twistedpickups/integrator/IntEnclosure_5_95_inside.png

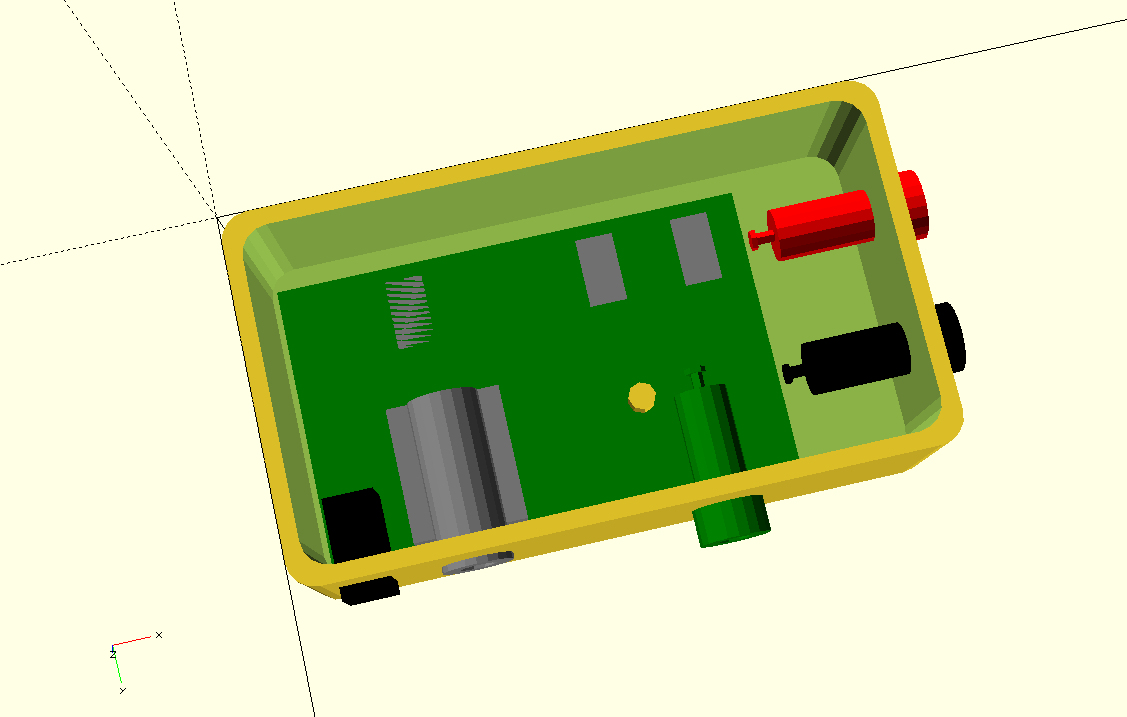
IntEnclosure_5_95_inside.png
