twistedpickups/integrator/IntEnclosure_5_95_topview.png

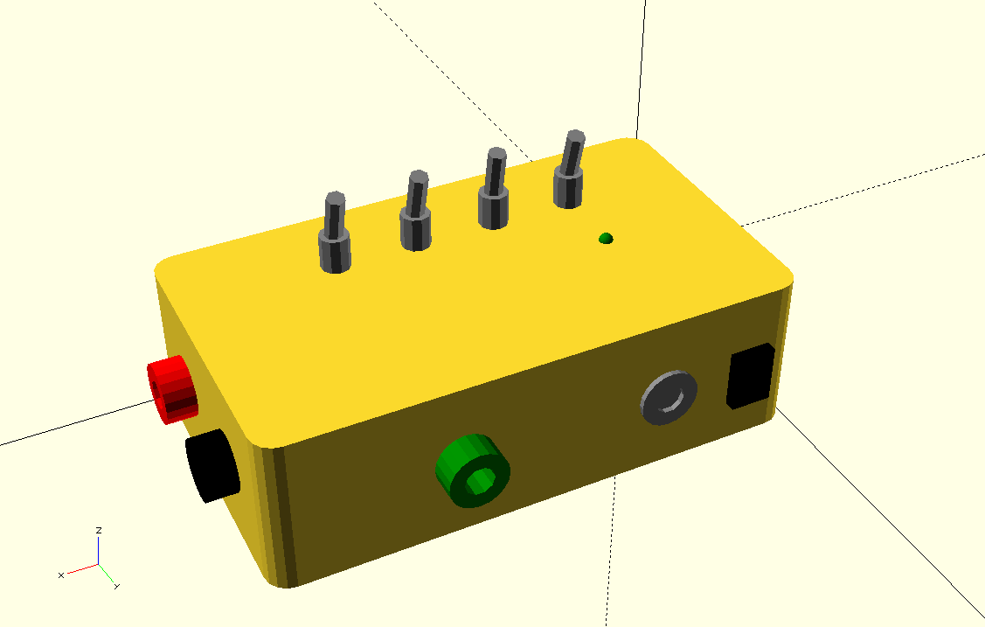
IntEnclosure_5_95_topview.png
