twistedpickups/integrator/V5.95-BOM.ods

Sheet: PCB
Designation | Value | Description | Part # | Manufacturer | Supplier | Supplier Part # | SMD Part | Cost $US | Cost per Unit (CAN$) | Notes
IC1 |  | JFET op amp | LT1058ACN | Linear Technology | Mouser | 584-LT1058CN#PBF | 584-LT1058SW#PBF | 10.27 | $11.91 | Substitutes: LT1058CN/OP482/LF347B/TL084
D1 | 6.2V/500mW | Zener diode | 1N753A | Central Semiconductor | Mouser | 610-1N753A | 771-BZV55-C6V2-T/R | 0.19 | $0.59
D2 |  | Reverse Protection Diode |  |  |  |  | 863-MBRS260T3G
LED1 | Green | LED | LTL-4231N | Lite-On | Mouser | 859-LTL-4231N |  |  | $0.10 | 3mm
S1 | On-off-on | toggle switch | 100SP3T1B1M2QEH | E-switch | Mouser | 612-100-C1121 |  |  | $4.06
S2 | On-on | toggle switch | 100SP1T1B1M2QEH | E-switch | Mouser | 612-100-A1121 |  |  | $3.37
S3 | On-on | toggle switch | 100SP1T1B1M2QEH | E-switch | Mouser | 612-100-A1121 |  |  | $3.37
S4 | DPDT | toggle switch |  | E-switch | Mouser |  | 612-100-F1121 |  | $3.37
R2 | 1.0M | 1/4W resistor 5% | CFR-25JR-52-1M | Yageo | Mouser | 603-CFR-25JR-52-1M | 71-RCG08051M00FKEA |  | $0.14
R6 | 1.8M | 1/4W resistor 5% | CFR-25JB-52-1M8 | Yageo | Mouser | 603-CFR-25JB-52-1M8 | 71-CRCW08051M80FKEA |  | $0.14
R8 | 1.8M | 1/4W resistor 5% | CFR-25JB-52-1M8 | Yageo | Mouser | 603-CFR-25JB-52-1M8 | 71-CRCW08051M80FKEA |  | $0.14
R9 | 10k | 1/4W resistor 5% | CFR-25JB-52-10K | Yageo | Mouser | 603-CFR-25JB-52-10K | 71-CRCW080510K0FKEAC |  | $0.14
R10 | 10k | 1/4W resistor 5% | CFR-25JB-52-10K | Yageo | Mouser | 603-CFR-25JR-52-10K | 71-CRCW080510K0FKEAC |  | $0.14
R1 | 9.1M | 1/4W resistor 5% | CFR-25JB-52-9M1 | Yageo | Mouser | 603-CFR-25JB-52-9M1 | 71-CRCW0805-9.1M-E3 |  | $0.14
R4 | 180k | 1/4W resistor 5% | CFR-25JB-52-180K | Yageo | Mouser | 603-CFR-25JB-52-180K | 652-CR0805FX-1803ELF |  | $0.14
R5 | 18k | 1/4W resistor 5% | CFS1/4CT52R183J | Koa Speer | Mouser | 660-CFS1/4CT52R183J | 660-RK73H2ATTD1802F |  | $0.24
R11 | 200k | 1/4W resistor 5% | CFR-25JB-52-200K | Yageo | Mouser | 603-CFR-25JB-52-200K | 660-RK73H2ATTD2003F |  | $0.14
R3 | 20k | 1/4W resistor 5% | CFR-25JB-52-20K | Yageo | Mouser | 603-CFR-25JB-52-20K | 652-CR0805FX-2002ELF |  | $0.14
R7 | 39k | 1/4W resistor 5% | CFR-25JR-52-39K | Yageo | Mouser | 603-CFR-25JR-52-39K | 660-RK73H2ATTDD3902F |  | $0.14
C4 | 0.1u | MLCC capacitor | SR215C104JARTR1 | AVX | Mouser | 581-SR215C104JARTR1 | 667-ECP-U1C104MA5 |  | $0.47 | 50V 5% | 16v,20% film
C8 | 0.1u | MLCC capacitor | SR215C104JARTR1 | AVX | Mouser | 581-SR215C104JARTR1 | 963-UMF212B7104KGHT |  | $0.47 | 50V 5% | 50V, 10% mlcc
C9 | 0.1u | MLCC capacitor | SR215C104JARTR1 | AVX | Mouser | 581-SR215C104JARTR1 | 963-UMF212B7104KGHT |  | $0.47 | 50V 5%
C6 | 10n | MLCC capacitor | SR155C103JAA | AVX | Mouser | 581-SR155C103JAA | 667-ECH-U1C103GX5 |  | $0.65 | 50V 5% | 16V,2%, film
C7 | 10u | tantalum capacitor | TAP106K025SCS | AVX | Mouser | 581-TAP106K025SCS | 581-TAJA106K016RNJV |  | $1.24 | 25V 10% | 16V, 10%
C5 | 1u | MLCC capacitor | C330C105J5R5TA | Kemet | Mouser | 80-C330C105J5R | 791-0805B105J250CT |  | $2.32 | 50V 5% | 25V, 5%, mlcc
C10 | 1u | MLCC capacitor | C330C105J5R5TA | Kemet | Mouser | 80-C330C105J5R | 791-0805B105J250CT |  | $2.32 | 50V 5% | 25V, 5%, mlcc
C3 | 20p | MLCC capacitor | SR211A200JAR | AVX | Mouser | 581-SR211A200JAR | 80-C0805C200J5HACTU |  | $0.51 | 100V 5% | 50V, 5%, mlcc
C12 | 4.7n | MLCC capacitor | SR215C472JARTR1 | AVX | Mouser | 581-SR215C472JARTR1 | 667-ECH-U1C472GX5 |  | $0.47 | 50V 5% | 16V, 2%, film
C11 | 470p | MLCC capacitor | SR215A471JARTR1 | AVX | Mouser | 581-SR215A471JARTR1 | 667-ECH-U1H471GX5 |  | $0.44 | 50V 5% | 50V, 2%, film
C1 | 4p | MLCC capacitor | RDE5C1H4R0C0S1H03A | Murata | Mouser | 81-RDE5C1H4R0C0S1H3A | 791-0805N4R0C500CT |  | $0.50 | 50V | 50V, +/-0.25%
C2 | 5-20p | trimmer capacitor | GKG20015 | Sprague-Goodman | Mouser | 659-GKG20015 |  |  | $6.07 | 6mm
CN1 |  | DC Power Jack |  |  | Mouser |  | 806-KLDHCX-0202-AC-1 | 1.01
BJ1 | Red | Banana Jack |  |  | Mouser |  | 108-0902-001 | 0.65
BJ2 | Black | Banana Jack |  |  | Mouser |  | 530-108-0903-1 | 0.64
BJ3 | Gnd | Banana Jack |  |  | Mouser |  | 530-108-0740-1 | 1.54
 |  |  |  |  |  | Approx cost/unit when purchasing 10x |  | $35.00 | $44.34

Sheet: Unit
Description | Part # | Manufacturer | Supplier | Supplier Part # | Cost per Unit (CAN$) | Notes
Housing | 1590B | Hammond | Mouser | 546-1590B | $10.36 | Use 1590BBK/Mouser 546-1590B-BK for black housing
