twistedpickups/integrator/InjectorTestCoil.stl

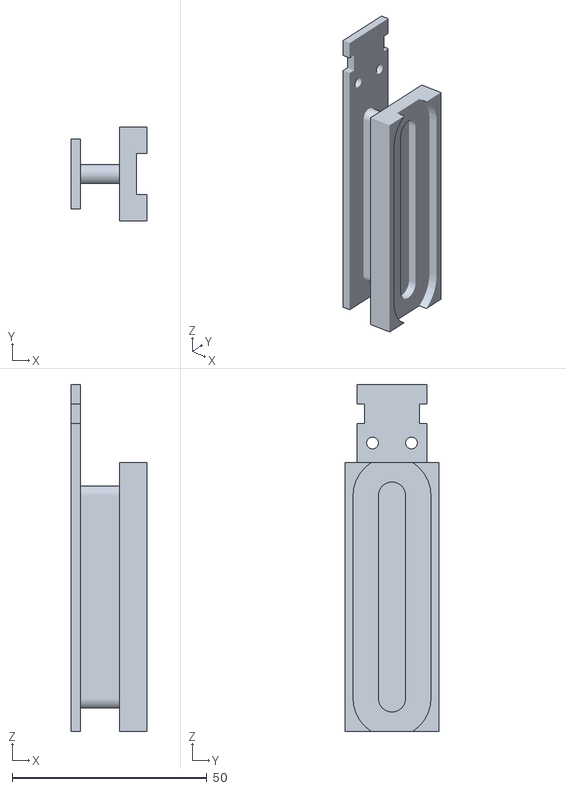
[picture p3: CAD file, 2019-09-10]
InjectorTestCoil.stl
19.4 x 24.0 x 89.0
