twistedpickups/integrator/V5.9aSMD.brd

## EAGLE design V5.9aSMD.brd (2019-09-15)

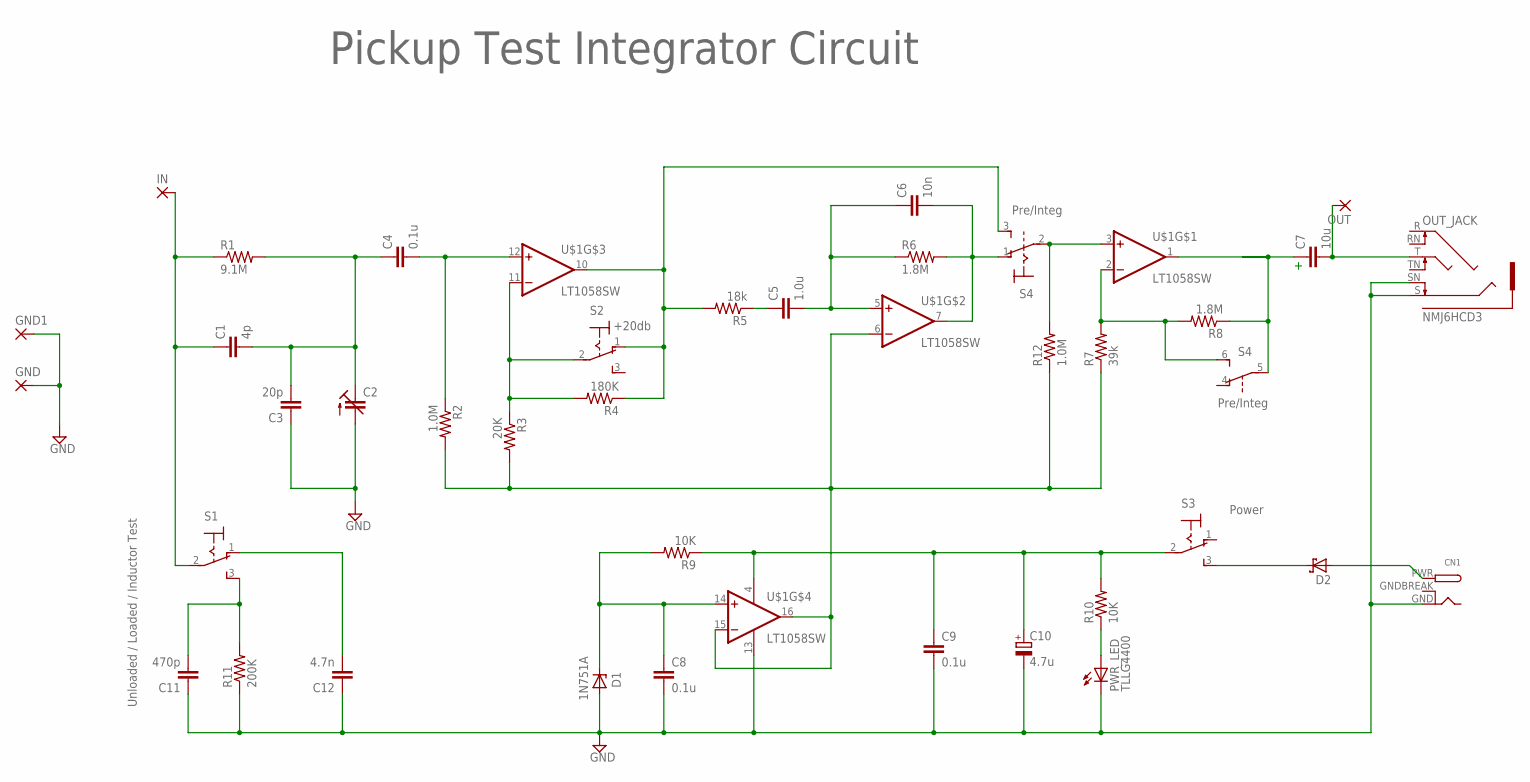
[picture p4: schematic V5.9aSMD.sch]

Parts:
C1: 4p; C0805
C2: C-TRIMMGKG20015; GKG20015
C3: 20p; C0805
C4, C8, C9: 0.1u; C0805
C5: 1.0u; C0805
C6: 10n; C0805
C7: 10u; C1206K
C10: 4.7u; A/3216-18R
C11: 470p; C0805
C12: 4.7n; C0805
CN1: DCBARRELPTH; DCJACK_2MM_PTH
D1: ZENER-DIODESOD80C; SOD80C
D2: SCHOTTKY-DIODESMD; SMB
GND, GND1: 2,54/1,1
IN: 2,54/1,1
OUT: 2,54/1,1
OUT_JACK: NMJ6HCD3; AUDIO_JACK_NEUTRIK
PWR_LED: TLLG4400; LED3MM
R1: 9.1M; R0805
R2, R12: 1.0M; R0805
R3: 20K; R0805
R4: 180K; R0805
R5: 18k; R0805
R6, R8: 1.8M; R0805
R7: 39k; R0805
R9, R10: 10K; R0805
R11: 200K; R0805
S1, S2, S3: 320-916
S4: 320-938
U$1: LT1058SW; SO16W

Connections:
GND: C2.1 (A), C3.1, C8.2, C9.2, C10.-, C11.1, C12.1, CN1.GND, D1.A, GND.1, GND1.1, OUT_JACK.S, OUT_JACK.SN, PWR_LED.K (C), R11.1, U$1.13 (V-)
GNDBREAK: CN1.GNDBREAK
IT: C12.2, S1.1 (O)
unnamed: PWR_LED.A, R10.1
unnamed: C5.1, R5.1
unnamed: D2.C, S3.3 (S)
unnamed: R4.1, R5.2, S2.1 (O), S4.3 (S), U$1.10 (OUT)
unnamed: R3.1, R4.2, S2.2, U$1.11 (-IN)
unnamed: C6.2, R6.2, S4.1 (O), U$1.7 (OUT)
unnamed: R7.2, R8.2, S4.6 (S), U$1.2 (-IN)
unnamed: C7.1, R8.1, S4.5, U$1.1 (OUT)
unnamed: C1.2, C2.2 (E), C3.2, C4.1, R1.2
unnamed: C8.1, D1.C, R9.2, U$1.14 (+IN)
unnamed: R12.2, S4.2, U$1.3 (+IN)
unnamed: C4.2, R2.1, U$1.12 (+IN)
unnamed: C1.1, IN.1, R1.1, S1.2
unnamed: R2.2, R3.2, R7.1, R12.1, U$1.6 (-IN), U$1.15 (-IN), U$1.16 (OUT)
unnamed: C9.1, C10.+, R9.1, R10.2, S3.2, U$1.4 (V+)
unnamed: C11.2, R11.2, S1.3 (S)
unnamed: C5.2, C6.1, R6.1, U$1.5 (+IN)
unnamed: CN1.PWR, D2.A
unnamed: C7.2, OUT.1, OUT_JACK.T

Notes on the sheet:
Pickup Test Integrator Circuit
Power
Pre/Integ
+20db
Unloaded / Loaded / Inductor Test

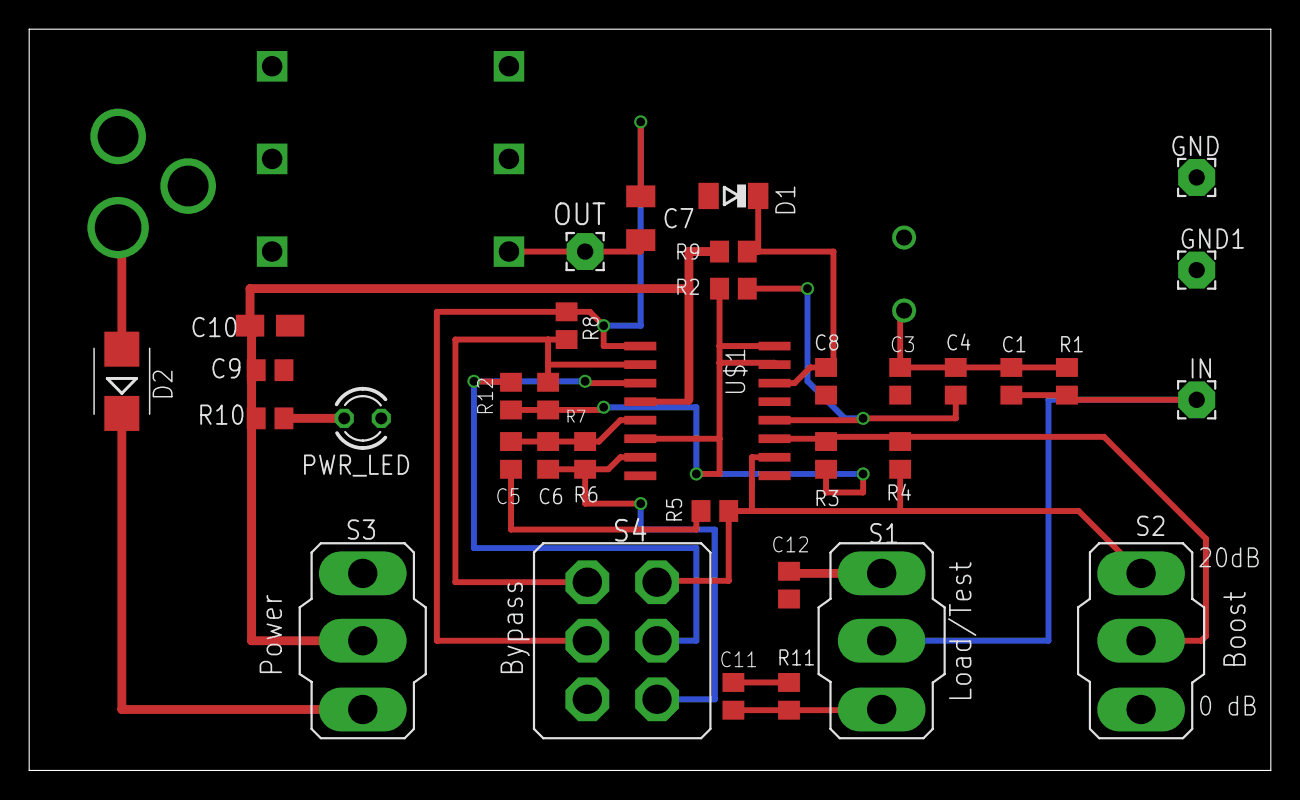
[picture p5: board V5.9aSMD.brd from above]

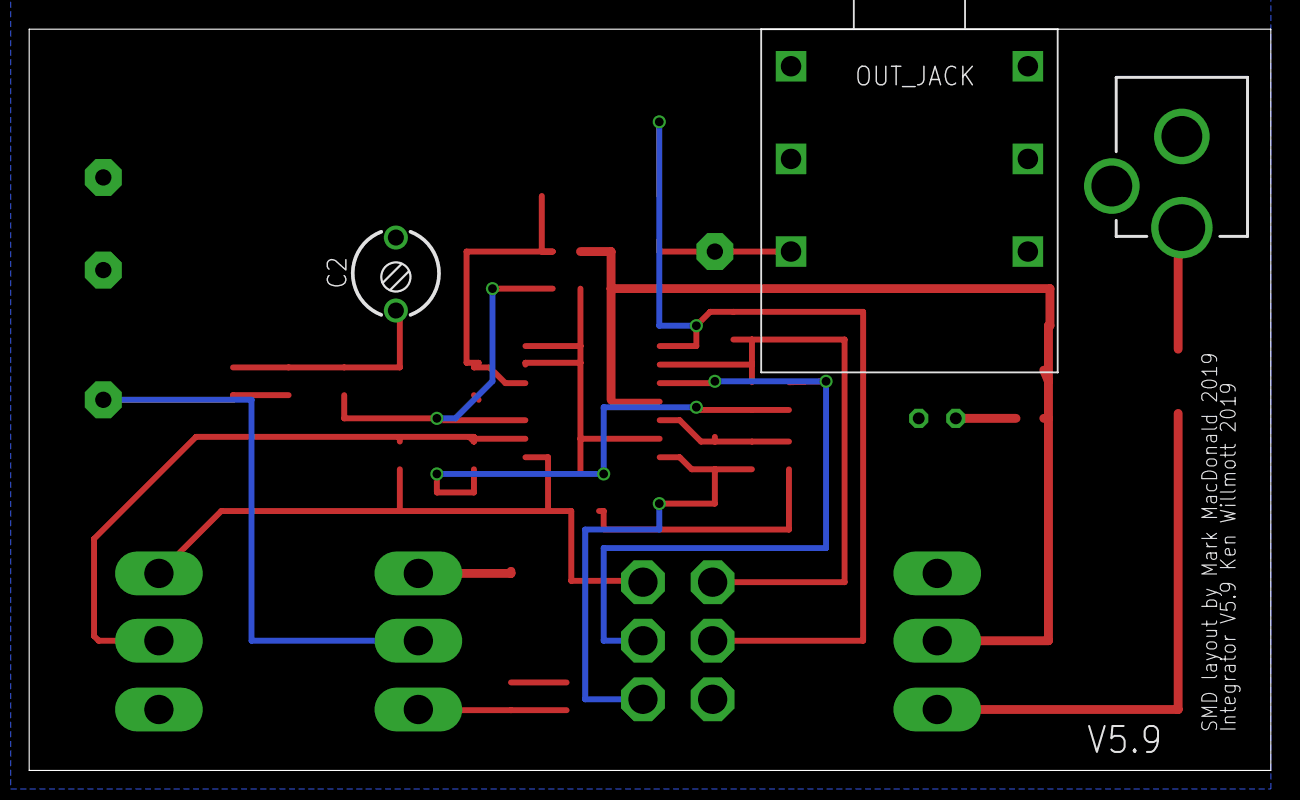
[picture p6: board V5.9aSMD.brd from below]

Board: 2 copper layers, 85.1 x 50.8 mm, 38 parts (3 on the bottom side), 21 nets.
