twistedpickups/integrator/(commit log)

2019-09-14 Updated bypass and i/o jacks
    [V5.9SMD.brd, V5.9SMD.sch]
2019-09-14 Add files via upload
    Updated board component footprints. Updated BOM for smd and new parts.
    [V5.95-BOM.ods, V5.9aSMD.brd, V5.9aSMD.sch]
2019-09-14 Add files via upload
    Scad file for enclosure mockup and renders
    [IntEnclosure_5_95.scad]
2019-09-15 Production files
    [V5.9aSMD.brd]
